anirudh-ramesh/x/Barometer 022.brd

## EAGLE design Barometer 022.brd (2023-05-06)

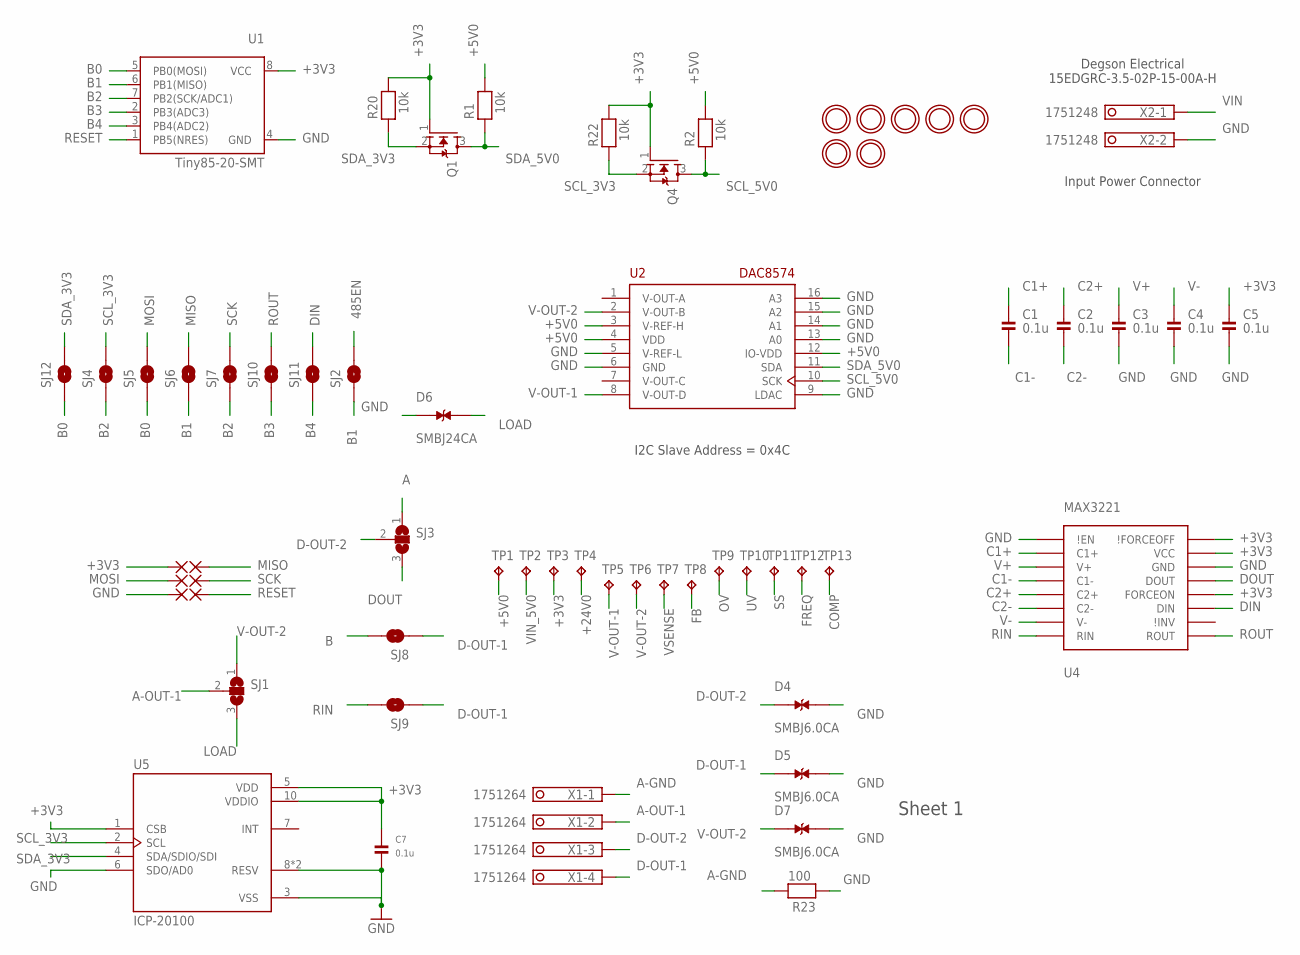
[picture p1: schematic Barometer 022.sch, sheet 1]

Parts:
C1, C2, C3, C4, C5, C7: 0.1u; 0603@1
D4, D5, D7: SMBJ6.0CA; DIOM4336X265N
D6: SMBJ24CA; DIOM4336X265N
PAD1, PAD2, PAD3, PAD4, PAD5, PAD6: SMD2; SMD1,27-2,54
Q1, Q4: MOSFET-NWIDE; SOT23-WIDE
R1, R2, R20, R22: 10k; 0603
R23: 100; 0603
SJ1: SJ2WW; SJ_2W
SJ2, SJ4, SJ5, SJ6, SJ7, SJ8, SJ9, SJ10, SJ11: SOLDERJUMPERTRACE; SJ_2S-TRACE
SJ3: SJ2W; SJ_2
SJ12: SOLDERJUMPERNO; SJ_2S-NO
TP1, TP2, TP3, TP4, TP5, TP6, TP7, TP8, TP9, TP10, TP11, TP12, TP13: TPB1,27; B1,27
U1: Tiny85-20-SMT; SO08-EIAJ_MCU
U2: DAC8574; TSSOP16
U4: MAX3221; TSSOP16
U5: ICP-20100; PQFN50P200X200X85-10N
U$1, U$2, U$3, U$4, U$5, U$6, U$7: MOUNTINGHOLE3.0THIN; MOUNTINGHOLE_3.0_PLATEDTHIN
X1: 1751264
X2: 1751248

Connections:
485EN: SJ2.2; also elsewhere on the board
+3V3: C5.1, C7.1, PAD1.1, Q1.1 (G), Q4.1 (G), R20.2, R22.2, TP3.TP, U1.8 (VCC), U4.12 (FORCEON), U4.15 (VCC), U4.16 (\!FORCEOFF), U5.1 (CSB), U5.5 (VDD), U5.10 (VDDIO); also elsewhere on the board
+5V0: R1.2, R2.2, TP1.TP, U2.3 (V-REF-H), U2.4 (VDD), U2.12 (IO-VDD); also elsewhere on the board
+24V0: TP4.TP; also elsewhere on the board
A: SJ3.1; also elsewhere on the board
A-GND: R23.2, X1.1
A-OUT-1: SJ1.2, X1.2
B: SJ8.2; also elsewhere on the board
B0: SJ5.1, SJ12.1, U1.5 (PB0(MOSI))
B1: SJ2.1, SJ6.1, U1.6 (PB1(MISO))
B2: SJ4.1, SJ7.1, U1.7 (PB2(SCK/ADC1))
B3: SJ10.1, U1.2 (PB3(ADC3))
B4: SJ11.1, U1.3 (PB4(ADC2))
C1+: C1.1, U4.2 (C1+)
C1-: C1.2, U4.4 (C1-)
C2+: C2.1, U4.5 (C2+)
C2-: C2.2, U4.6 (C2-)
COMP: TP13.TP; also elsewhere on the board
D-OUT-1: D5.1, SJ8.1, SJ9.1, X1.4
D-OUT-2: D4.1, SJ3.2, X1.3
DIN: SJ11.2, U4.11 (DIN); also elsewhere on the board
DOUT: SJ3.3, U4.13 (DOUT)
FB: TP8.TP; also elsewhere on the board
FREQ: TP12.TP; also elsewhere on the board
GND: C3.2, C4.2, C5.2, C7.2, D4.2, D5.2, D6.1, D7.2, PAD5.1, R23.1, U1.4 (GND), U2.5 (V-REF-L), U2.6 (GND), U2.9 (LDAC), U2.13 (A0), U2.14 (A1), U2.15 (A2), U2.16 (A3), U4.1 (\!EN), U4.14 (GND), U5.3 (VSS), U5.6 (SDO/AD0), U5.8 (RESV), U5.9 (RESV), X2.2; also elsewhere on the board
LOAD: D6.2, SJ1.3; also elsewhere on the board
MISO: PAD2.1, SJ6.2
MOSI: PAD3.1, SJ5.2
OV: TP9.TP; also elsewhere on the board
RESET: PAD6.1, U1.1 (PB5(NRES))
RIN: SJ9.2, U4.8 (RIN)
ROUT: SJ10.2, U4.9 (ROUT); also elsewhere on the board
SCK: PAD4.1, SJ7.2
SCL_3V3: Q4.2 (S), R22.1, SJ4.2, U5.2 (SCL)
SCL_5V0: Q4.3 (D), R2.1, U2.10 (SCK)
SDA_3V3: Q1.2 (S), R20.1, SJ12.2, U5.4 (SDA/SDIO/SDI)
SDA_5V0: Q1.3 (D), R1.1, U2.11 (SDA)
SS: TP11.TP; also elsewhere on the board
UV: TP10.TP; also elsewhere on the board
V+: C3.1, U4.3 (V+)
V-: C4.1, U4.7 (V-)
V-OUT-1: TP5.TP, U2.8 (V-OUT-D); also elsewhere on the board
V-OUT-2: D7.1, SJ1.1, TP6.TP, U2.2 (V-OUT-B)
VIN: X2.1; also elsewhere on the board
VIN_5V0: TP2.TP; also elsewhere on the board
VSENSE: TP7.TP; also elsewhere on the board

Notes on the sheet:
Sheet 1
I2C Slave Address = 0x4C
Input Power Connector
Degson Electrical 15EDGRC-3.5-02P-15-00A-H

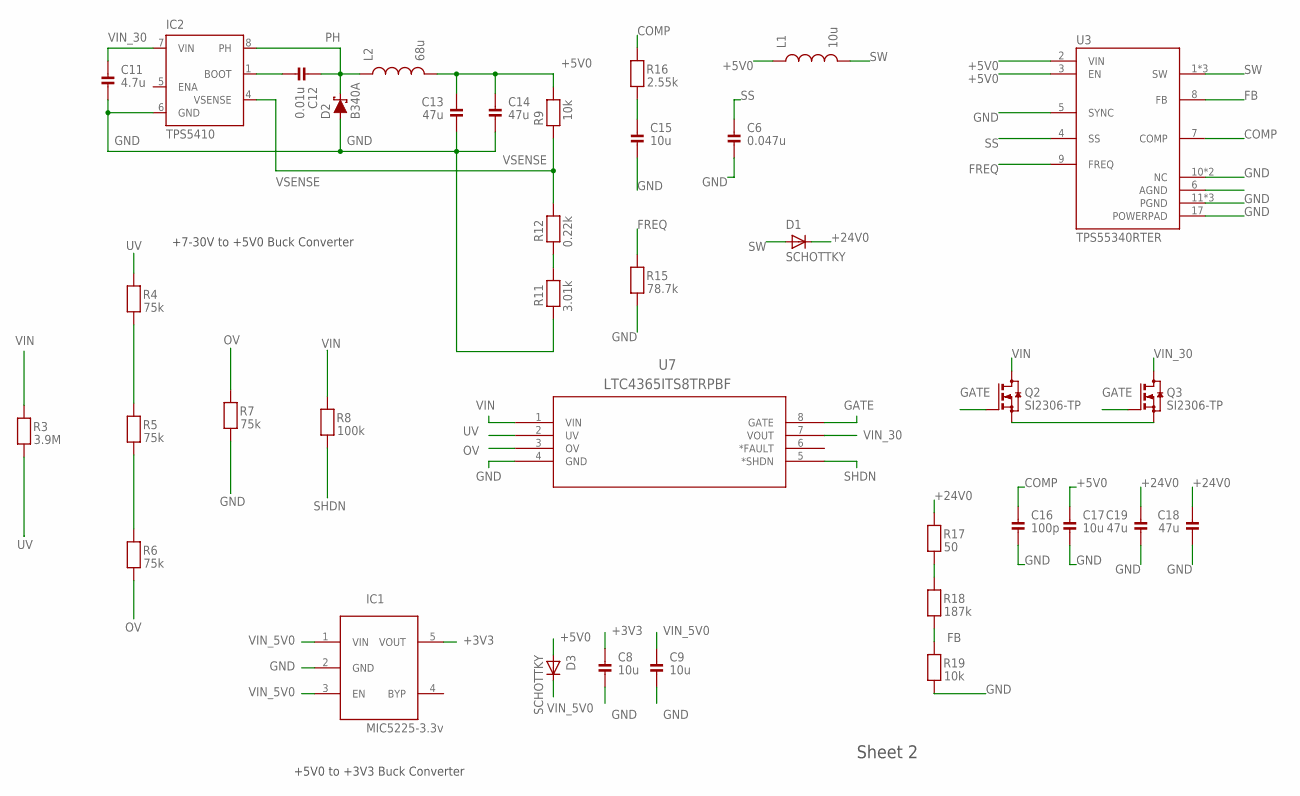
[picture p2: schematic Barometer 022.sch, sheet 2]

Parts:
C6: 0.047u; 0603@1
C8, C9, C15, C17: 10u; 0603@1
C11: 4.7u; 0805@1
C12: 0.01u; 0603@1
C13, C14, C18, C19: 47u; 1206@1
C16: 100p; 0603@1
D1, D3: SCHOTTKY; SOD-123FL
D2: B340A; SMA-DIODE
IC1: MIC5225-3.3v; SOT23-5L
IC2: TPS5410; D_R-PDSO-G08
L1: 10u; VLS6045EX
L2: 68u; VLS6045EX
Q2, Q3: SI2306-TP; SOT23
R3: 3.9M; 0603
R4, R5, R6, R7: 75k; 0603
R8: 100k; 0603
R9, R19: 10k; 0603
R11: 3.01k; 0603
R12: 0.22k; 0603
R15: 78.7k; 0603
R16: 2.55k; 0603
R17: 50; 0603
R18: 187k; 0603
U3: TPS55340RTER; QFN50P300X300X80-17N
U7: LTC4365ITS8TRPBF; TSOT-23_TS8

Connections:
+3V3: C8.1, IC1.5 (VOUT); also elsewhere on the board
+5V0: C13.1, C14.1, C17.1, D3.A, L1.1, L2.2, R9.2, U3.2 (VIN), U3.3 (EN); also elsewhere on the board
+24V0: C18.1, C19.1, D1.C, R17.2; also elsewhere on the board
BOOT1: C12.2, IC2.1 (BOOT)
COMP: C16.1, R16.2, U3.7 (COMP); also elsewhere on the board
FB: R18.1, R19.2, U3.8 (FB); also elsewhere on the board
FREQ: R15.2, U3.9 (FREQ); also elsewhere on the board
GATE: Q2.1 (G), Q3.1 (G), U7.8 (GATE)
GND: C6.2, C8.2, C9.2, C11.2, C13.2, C14.2, C15.2, C16.2, C17.2, C18.2, C19.2, D2.A, IC1.2 (GND), IC2.6 (GND), R7.1, R11.1, R15.1, R19.1, U3.5 (SYNC), U3.10 (NC), U3.11 (PGND), U3.12 (PGND), U3.13 (PGND), U3.14 (NC), U3.17 (POWERPAD), U7.4 (GND); also elsewhere on the board
unnamed: C15.1, R16.1
unnamed: R4.1, R5.2
unnamed: Q2.2 (S), Q3.2 (S)
unnamed: R5.1, R6.2
unnamed: R11.2, R12.1
unnamed: R17.1, R18.2
OV: R6.1, R7.2, U7.3 (OV); also elsewhere on the board
PH: C12.1, D2.C, IC2.8 (PH), L2.1
SHDN: R8.1, U7.5 (*SHDN)
SS: C6.1, U3.4 (SS); also elsewhere on the board
SW: D1.A, L1.2, U3.1 (SW), U3.15 (SW), U3.16 (SW)
UV: R3.1, R4.2, U7.2 (UV); also elsewhere on the board
VIN: Q2.3 (D), R3.2, R8.2, U7.1 (VIN); also elsewhere on the board
VIN_5V0: C9.1, D3.C, IC1.1 (VIN), IC1.3 (EN); also elsewhere on the board
VIN_30: C11.1, IC2.7 (VIN), Q3.3 (D), U7.7 (VOUT)
VSENSE: IC2.4 (VSENSE), R9.1, R12.2; also elsewhere on the board

Notes on the sheet:
Sheet 2
+7-30V to +5V0 Buck Converter
+5V0 to +3V3 Buck Converter

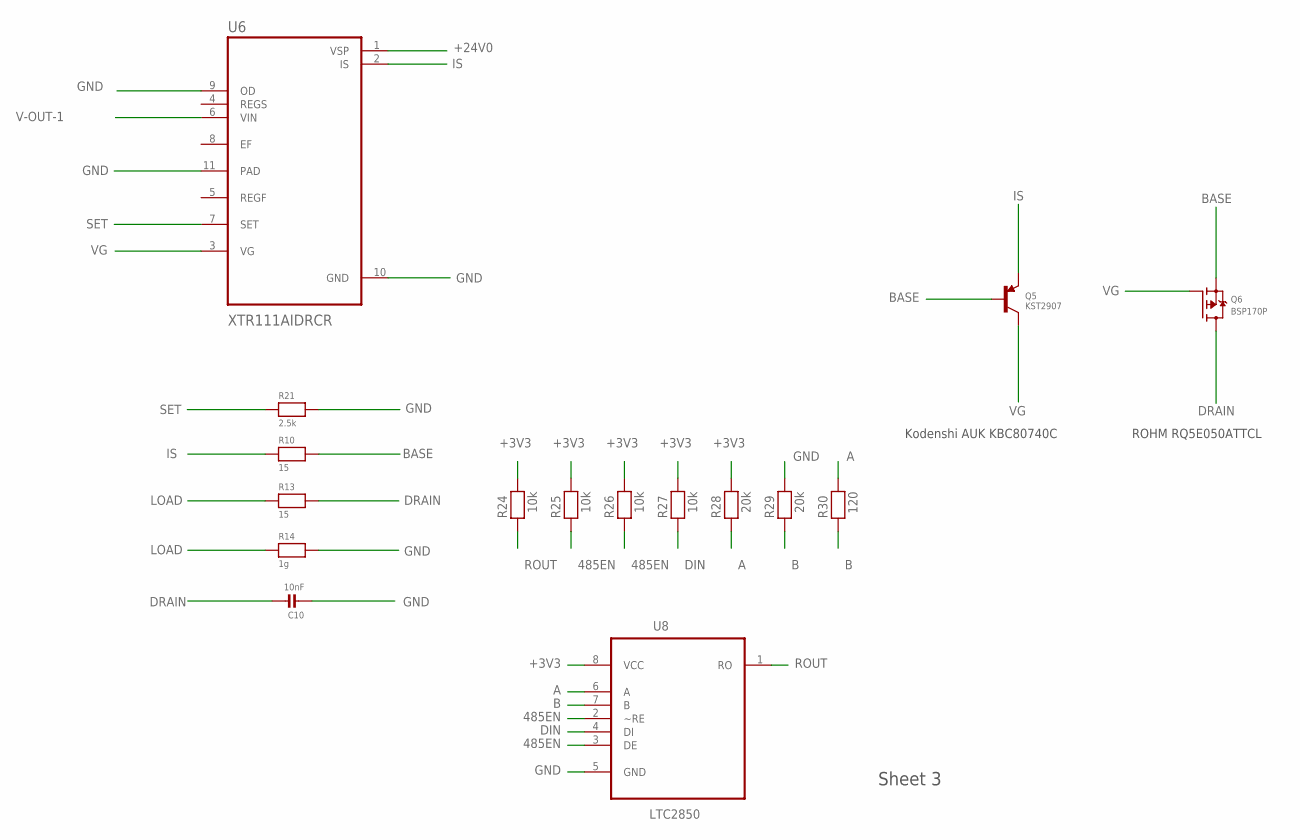
[picture p3: schematic Barometer 022.sch, sheet 3]

Parts:
C10: 10nF; 0603@1
Q5: KST2907; SOT23-R
Q6: BSP170P; SOT23-R
R10, R13: 15; 0603
R14: 1g; 0603
R21: 2.5k; 0603
R24, R25, R26, R27: 10k; 0603
R28, R29: 20k; 0603
R30: 120; 0603
U6: XTR111AIDRCR; VREG_V62/16624-01YE
U8: LTC2850; SOIC127P600X175-8N

Connections:
485EN: R25.1, R26.1, U8.2 (~RE), U8.3 (DE); also elsewhere on the board
+3V3: R24.2, R25.2, R26.2, R27.2, R28.2, U8.8 (VCC); also elsewhere on the board
+24V0: U6.1 (VSP); also elsewhere on the board
A: R28.1, R30.2, U8.6 (A); also elsewhere on the board
B: R29.1, R30.1, U8.7 (B); also elsewhere on the board
BASE: Q5.1 (B), Q6.2 (S), R10.2
DIN: R27.1, U8.4 (DI); also elsewhere on the board
DRAIN: C10.2, Q6.3 (D), R13.2
GND: C10.1, R14.2, R21.2, R29.2, U6.9 (OD), U6.10 (GND), U6.11 (PAD), U8.5 (GND); also elsewhere on the board
IS: Q5.2 (E), R10.1, U6.2 (IS)
LOAD: R13.1, R14.1; also elsewhere on the board
ROUT: R24.1, U8.1 (RO); also elsewhere on the board
SET: R21.1, U6.7 (SET)
V-OUT-1: U6.6 (VIN); also elsewhere on the board
VG: Q5.3 (C), Q6.1 (G), U6.3 (VG)

Notes on the sheet:
Sheet 3
ROHM RQ5E050ATTCL
Kodenshi AUK KBC80740C

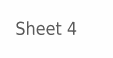
[picture p4: schematic Barometer 022.sch, sheet 4]

Notes on the sheet:
Sheet 4

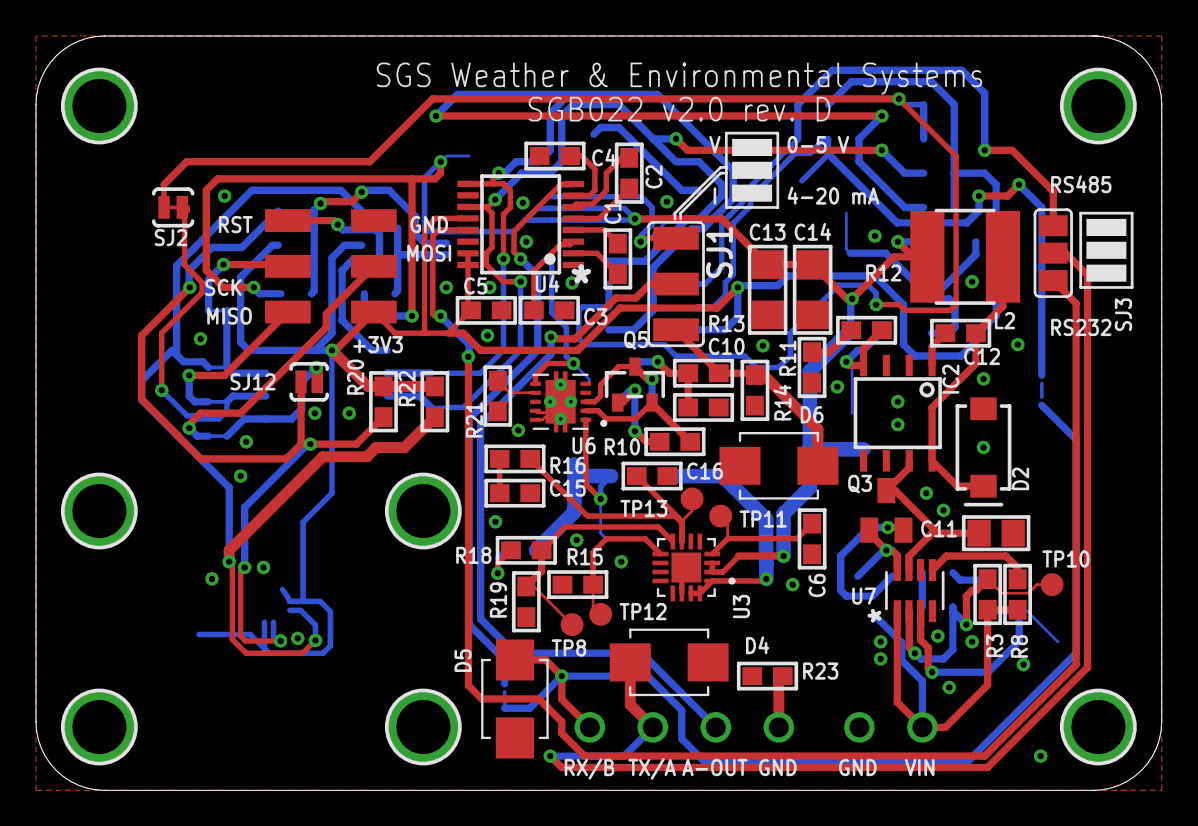
[picture p5: board Barometer 022.brd from above]

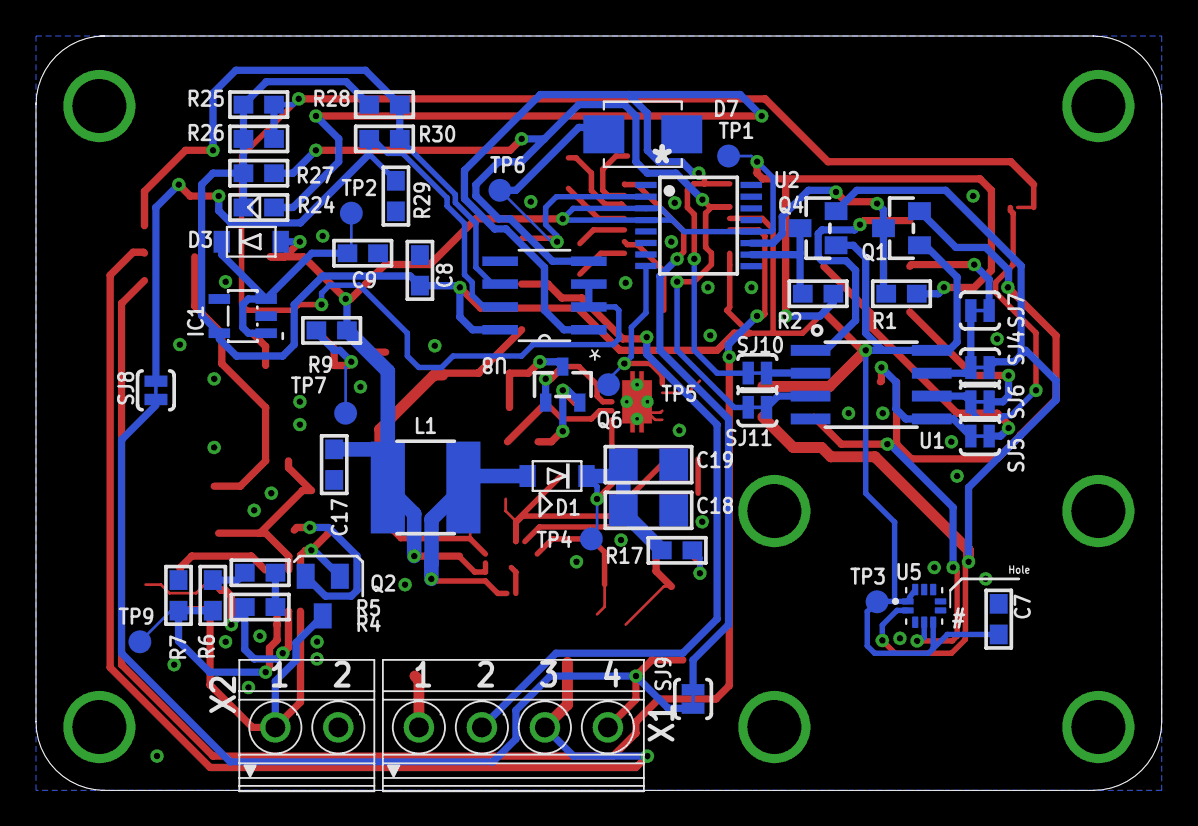
[picture p6: board Barometer 022.brd from below]

Board: 2 copper layers, 62.5 x 41.9 mm, 114 parts (52 on the bottom side), 63 nets.
